GavynDracula/FiveStage-MIPS-CPU/README.md

### 支持多级嵌套中断和动态分支预测的5段流水MIPS CPU
#### 具体内容请参考requirement.docx和report
