GavynDracula/FiveStage-MIPS-CPU/Logisim/README.txt

最终版本为5-stage-cpu.circ，支持动态分支预测和中断的重定向流水线CPU
