GavynDracula/FiveStage-MIPS-CPU/Verilog/README.txt

大小问题，只给出源文件文件夹（Verilog工程名为“cpu”）和测试文件文件夹
