GavynDracula/FiveStage-MIPS-CPU/Verilog/testfile/benchmark-ir-pipeline.txt

08000d19
08000c05
08000c4a
08000c8f
08000cd4
27bdffff
afa40000
27bdffff
afa20000
27bdffff
afb00000
27bdffff
afb10000
27bdffff
40114000
00000000
00000000
afb10000
27bdffff
40114800
00000000
00000000
afb10000
20100002
00000000
00000000
40904000
00000000
00000000
00000000
40104000
00000000
00000000
36100001
00000000
00000000
40904000
20020001
20040000
0000000c
2010000f
2004000f
0000000c
20110007
00108100
02042020
0000000c
2231ffff
1620fffb
20100002
00000000
00000000
40904000
8fb10000
00000000
00000000
40914800
27bd0001
8fb10000
00118842
00118840
00000000
00000000
40914000
27bd0001
8fb10000
27bd0001
8fb00000
27bd0001
8fa20000
27bd0001
8fa40000
27bd0001
42000018
27bdffff
afa40000
27bdffff
afa20000
27bdffff
afb00000
27bdffff
afb10000
27bdffff
40114000
00000000
00000000
afb10000
27bdffff
40114800
00000000
00000000
afb10000
20100006
00000000
00000000
40904000
00000000
00000000
00000000
40104000
00000000
00000000
36100001
00000000
00000000
40904000
20020001
20040000
0000000c
20100001
20040001
0000000c
20110007
00108100
02042020
0000000c
2231ffff
1620fffb
20100006
00000000
00000000
40904000
8fb10000
00000000
00000000
40914800
27bd0001
8fb10000
00118842
00118840
00000000
00000000
40914000
27bd0001
8fb10000
27bd0001
8fb00000
27bd0001
8fa20000
27bd0001
8fa40000
27bd0001
42000018
27bdffff
afa40000
27bdffff
afa20000
27bdffff
afb00000
27bdffff
afb10000
27bdffff
40114000
00000000
00000000
afb10000
27bdffff
40114800
00000000
00000000
afb10000
2010000e
00000000
00000000
40904000
00000000
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
00102020
20020022
0000000c
22100002
00102020
20020022
0000000c
22100003
00102020
20020022
0000000c
22100004
00102020
20020022
0000000c
22100005
00102020
20020022
0000000c
22100006
00102020
20020022
0000000c
22100007
00102020
20020022
0000000c
22100008
00102020
20020022
20020022
0000000c
03e00008
