GavynDracula/FiveStage-MIPS-CPU/Verilog/testfile/benchmark.txt

20110001
08000c05
20110001
20120002
20130003
08000c09
20110001
20120002
20130003
08000c0d
20110001
20120002
20130003
08000c11
20110001
20120002
20130003
0c000cb8
20100001
20110001
00118fc0
00112020
20020022
0000000c
00118882
12200001
08000c15
00112020
20020022
0000000c
20110001
00118880
00112020
20020022
0000000c
12200001
08000c1f
20110001
00118fc0
00112020
20020022
0000000c
001188c3
00112020
20020022
0000000c
00118903
00112020
20020022
0000000c
00118903
00112020
20020022
0000000c
00118903
00112020
20020022
0000000c
00118903
00112020
20020022
0000000c
00118903
00112020
20020022
0000000c
00118903
00112020
20020022
0000000c
00118903
00112020
20020022
0000000c
20100001
00109fc0
00139fc3
00008021
2012000c
24160003
26100001
3210000f
20080008
20090001
00139900
02709825
00132020
20020022
0000000c
01094022
1500fff9
22100001
2018000f
02188024
00108700
20080008
20090001
00139902
02709825
00132021
20020022
0000000c
01094022
1500fff9
00108702
02c9b022
12c00001
08000c50
00004020
01084027
00084400
3508ffff
00082021
20020022
0000000c
2010ffff
20110000
ae300000
22100001
22310004
ae300000
22100001
22310004
ae300000
22100001
22310004
ae300000
22100001
22310004
ae300000
22100001
22310004
ae300000
22100001
22310004
ae300000
22100001
22310004
ae300000
22100001
22310004
ae300000
22100001
22310004
ae300000
22100001
22310004
ae300000
22100001
22310004
ae300000
22100001
22310004
ae300000
22100001
22310004
ae300000
22100001
22310004
ae300000
22100001
22310004
ae300000
22100001
22310004
22100001
00008020
2011003c
8e130000
8e340000
0274402a
11000002
ae330000
ae140000
2231fffc
1611fff8
00102020
20020022
0000000c
22100004
2011003c
1611fff2
2002000a
0000000c
20100000
22100001
00102020
20020022
0000000c
22100002
00102020
20020022
0000000c
22100003
00102020
20020022
0000000c
22100004
00102020
20020022
0000000c
22100005
00102020
20020022
0000000c
22100006
00102020
20020022
0000000c
22100007
00102020
20020022
0000000c
22100008
00102020
20020022
20020022
0000000c
03e00008
