GavynDracula/FiveStage-MIPS-CPU/(list of files, drawings)

Other design files:
Logisim/5-stage-cpu-ideal.circ
Logisim/5-stage-cpu-redirect.circ
Logisim/5-stage-cpu.circ
Logisim/alu-cpu.circ
Logisim/ext-cpu.circ
Logisim/ir-cpu.circ
Logisim/regfile-5-stage-cpu-bubble.circ
Logisim/regfile-5-stage-cpu.circ
Logisim/regfile-cpu.circ
