GavynDracula/FiveStage-MIPS-CPU/Verilog/cpu.srcs/sources_1/new/adder.v

`timescale 1ns / 1ps
//////////////////////////////////////////////////////////////////////////////////
// Company: 
// Engineer: 
// 
// Create Date: 2017/02/26 12:40:56
// Design Name: 
// Module Name: adder
// Project Name: 
// Target Devices: 
// Tool Versions: 
// Description: 
// 
// Dependencies: 
// 
// Revision:
// Revision 0.01 - File Created
// Additional Comments:
// 
//////////////////////////////////////////////////////////////////////////////////


module adder(
    input [3:0] x,
    input [3:0] y,
    input c0,
    output [3:0] s,
    output c4,
    output pout, gout
    );
    wire [3:0] p, g, c;
    assign p = x ^ y;
    assign g = x & y;
    assign c[0] = c0;
    assign c[1] = g[0] | (p[0] & c[0]);
    assign c[2] = g[1] | (p[1] & g[0]) | (p[1] & p[0] & c[0]);
    assign c[3] = g[2] | (p[2] & g[1]) | (p[2] & p[1] & g[0]) | (p[2] & p[1] & p[0] & c[0]);
    assign s = p ^ c;
    assign c4 =  g[3] | (p[3] & g[2]) | (p[3] & p[2] & g[1]) | (p[3] & p[2] & p[1] & g[0]) | (p[3] & p[2] & p[1] & p[0] | c[0]);
    assign pout = p[3] & p[2] & p[1] & p[0];
    assign gout = g[3] | (p[3] & g[2]) | (p[3] & p[2] & g[1]) | (p[3] & p[2] & p[1] & g[0]);
endmodule
