GavynDracula/FiveStage-MIPS-CPU/Verilog/cpu.srcs/constrs_1/new/pipeline_cpu_test.xdc

set_property PACKAGE_PIN U9 [get_ports disp_key0]
set_property IOSTANDARD LVCMOS33 [get_ports disp_key0]
set_property PACKAGE_PIN U8 [get_ports disp_key1]
set_property IOSTANDARD LVCMOS33 [get_ports disp_key1]

set_property PACKAGE_PIN R7 [get_ports switch_key]
set_property IOSTANDARD LVCMOS33 [get_ports switch_key]

set_property PACKAGE_PIN R6 [get_ports memr_key0]
set_property IOSTANDARD LVCMOS33 [get_ports memr_key0]
set_property PACKAGE_PIN R5 [get_ports memr_key1]
set_property IOSTANDARD LVCMOS33 [get_ports memr_key1]
set_property PACKAGE_PIN V7 [get_ports memr_key2]
set_property IOSTANDARD LVCMOS33 [get_ports memr_key2]
set_property PACKAGE_PIN V6 [get_ports memr_key3]
set_property IOSTANDARD LVCMOS33 [get_ports memr_key3]


set_property PACKAGE_PIN P4 [get_ports rst_key]
set_property IOSTANDARD LVCMOS33 [get_ports rst_key]

set_property PACKAGE_PIN R3 [get_ports IRSrc[3]]
set_property IOSTANDARD LVCMOS33 [get_ports IRSrc[3]]
set_property PACKAGE_PIN T1 [get_ports IRSrc[2]]
set_property IOSTANDARD LVCMOS33 [get_ports IRSrc[2]]
set_property PACKAGE_PIN T3 [get_ports IRSrc[1]]
set_property IOSTANDARD LVCMOS33 [get_ports IRSrc[1]]
set_property PACKAGE_PIN U2 [get_ports IRSrc[0]]
set_property IOSTANDARD LVCMOS33 [get_ports IRSrc[0]]

set_property PACKAGE_PIN U1 [get_ports IRWT[3]]
set_property IOSTANDARD LVCMOS33 [get_ports IRWT[3]]
set_property PACKAGE_PIN P5 [get_ports IRWT[2]]
set_property IOSTANDARD LVCMOS33 [get_ports IRWT[2]]
set_property PACKAGE_PIN R1 [get_ports IRWT[1]]
set_property IOSTANDARD LVCMOS33 [get_ports IRWT[1]]
set_property PACKAGE_PIN V1 [get_ports IRWT[0]]
set_property IOSTANDARD LVCMOS33 [get_ports IRWT[0]]

set_property PACKAGE_PIN E3 [get_ports fq100m]
set_property IOSTANDARD LVCMOS33 [get_ports fq100m]

set_property PACKAGE_PIN L3 [get_ports seg[6]]
set_property IOSTANDARD LVCMOS33 [get_ports seg[6]]
set_property PACKAGE_PIN N1 [get_ports seg[5]]
set_property IOSTANDARD LVCMOS33 [get_ports seg[5]]
set_property PACKAGE_PIN L5 [get_ports seg[4]]
set_property IOSTANDARD LVCMOS33 [get_ports seg[4]]
set_property PACKAGE_PIN L4 [get_ports seg[3]]
set_property IOSTANDARD LVCMOS33 [get_ports seg[3]]
set_property PACKAGE_PIN K3 [get_ports seg[2]]
set_property IOSTANDARD LVCMOS33 [get_ports seg[2]]
set_property PACKAGE_PIN M2 [get_ports seg[1]]
set_property IOSTANDARD LVCMOS33 [get_ports seg[1]]
set_property PACKAGE_PIN L6 [get_ports seg[0]]
set_property IOSTANDARD LVCMOS33 [get_ports seg[0]]

set_property PACKAGE_PIN N6 [get_ports an[0]]
set_property IOSTANDARD LVCMOS33 [get_ports an[0]]
set_property PACKAGE_PIN M6 [get_ports an[1]]
set_property IOSTANDARD LVCMOS33 [get_ports an[1]]
set_property PACKAGE_PIN M3 [get_ports an[2]]
set_property IOSTANDARD LVCMOS33 [get_ports an[2]]
set_property PACKAGE_PIN N5 [get_ports an[3]]
set_property IOSTANDARD LVCMOS33 [get_ports an[3]]
set_property PACKAGE_PIN N2 [get_ports an[4]]
set_property IOSTANDARD LVCMOS33 [get_ports an[4]]
set_property PACKAGE_PIN N4 [get_ports an[5]]
set_property IOSTANDARD LVCMOS33 [get_ports an[5]]
set_property PACKAGE_PIN L1 [get_ports an[6]]
set_property IOSTANDARD LVCMOS33 [get_ports an[6]]
set_property PACKAGE_PIN M1 [get_ports an[7]]
set_property IOSTANDARD LVCMOS33 [get_ports an[7]]

set_property CLOCK_DEDICATED_ROUTE FALSE [get_nets IRSrc_IBUF[0]]
set_property CLOCK_DEDICATED_ROUTE FALSE [get_nets IRSrc_IBUF[1]]
set_property CLOCK_DEDICATED_ROUTE FALSE [get_nets IRSrc_IBUF[2]]
set_property CLOCK_DEDICATED_ROUTE FALSE [get_nets IRSrc_IBUF[3]]
